Zipra1/Fuimini-V2/README.md

# This design is currently under development.
I do not recommend making this at the moment.
Case is currently not finished, but it should work.

nRF52833 based smol SlimeVR tracker

Design is optimized for manufacturability at medium scales & comfort
