Zipra1/Fuimini-V2/Accessories/Mini extension cable Desk stand.STEP

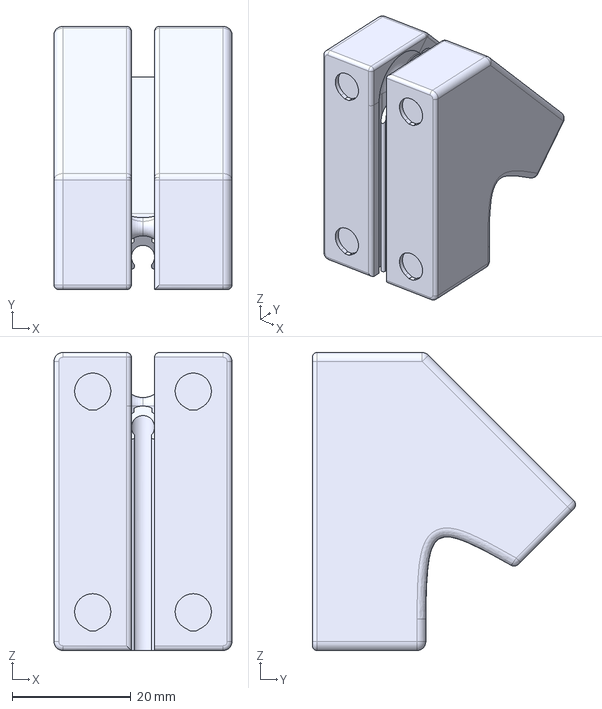
[picture p1: CAD file, 2025-12-10]
Accessories/Mini extension cable Desk stand.STEP
30.0 x 44.3 x 50.2 mm
