Zipra1/Fuimini-V2/Case models/Case.STEP

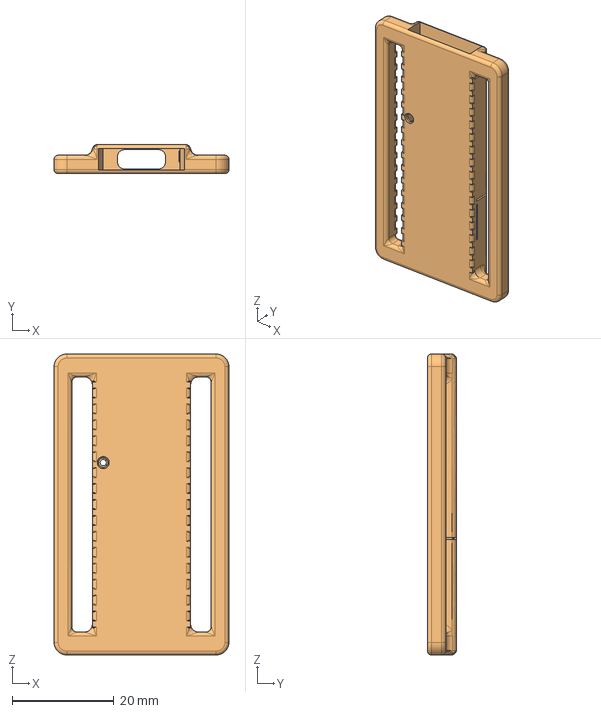
[picture p2: CAD file, 2025-12-30]
Case models/Case.STEP
34.3 x 5.71 x 59.0 mm
