Zipra1/Fuimini-V2/Case models/End cap.STEP

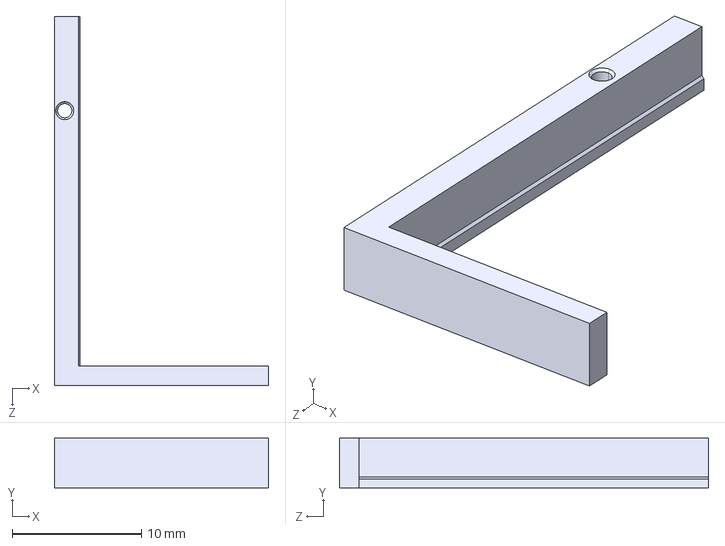
[picture p3: CAD file, 2025-12-30]
Case models/End cap.STEP
16.6 x 3.85 x 28.6 mm
