Zipra1/Fuimini-V2/(list of files, cad)

Other CAD files:
Tools/TC2030.STEP
