Zipra1/Fuimini-V2/KiCad/Fuimini-V2.kicad_pcb

## KiCad design KiCad/Fuimini-V2.kicad_pcb (2025-12-10)

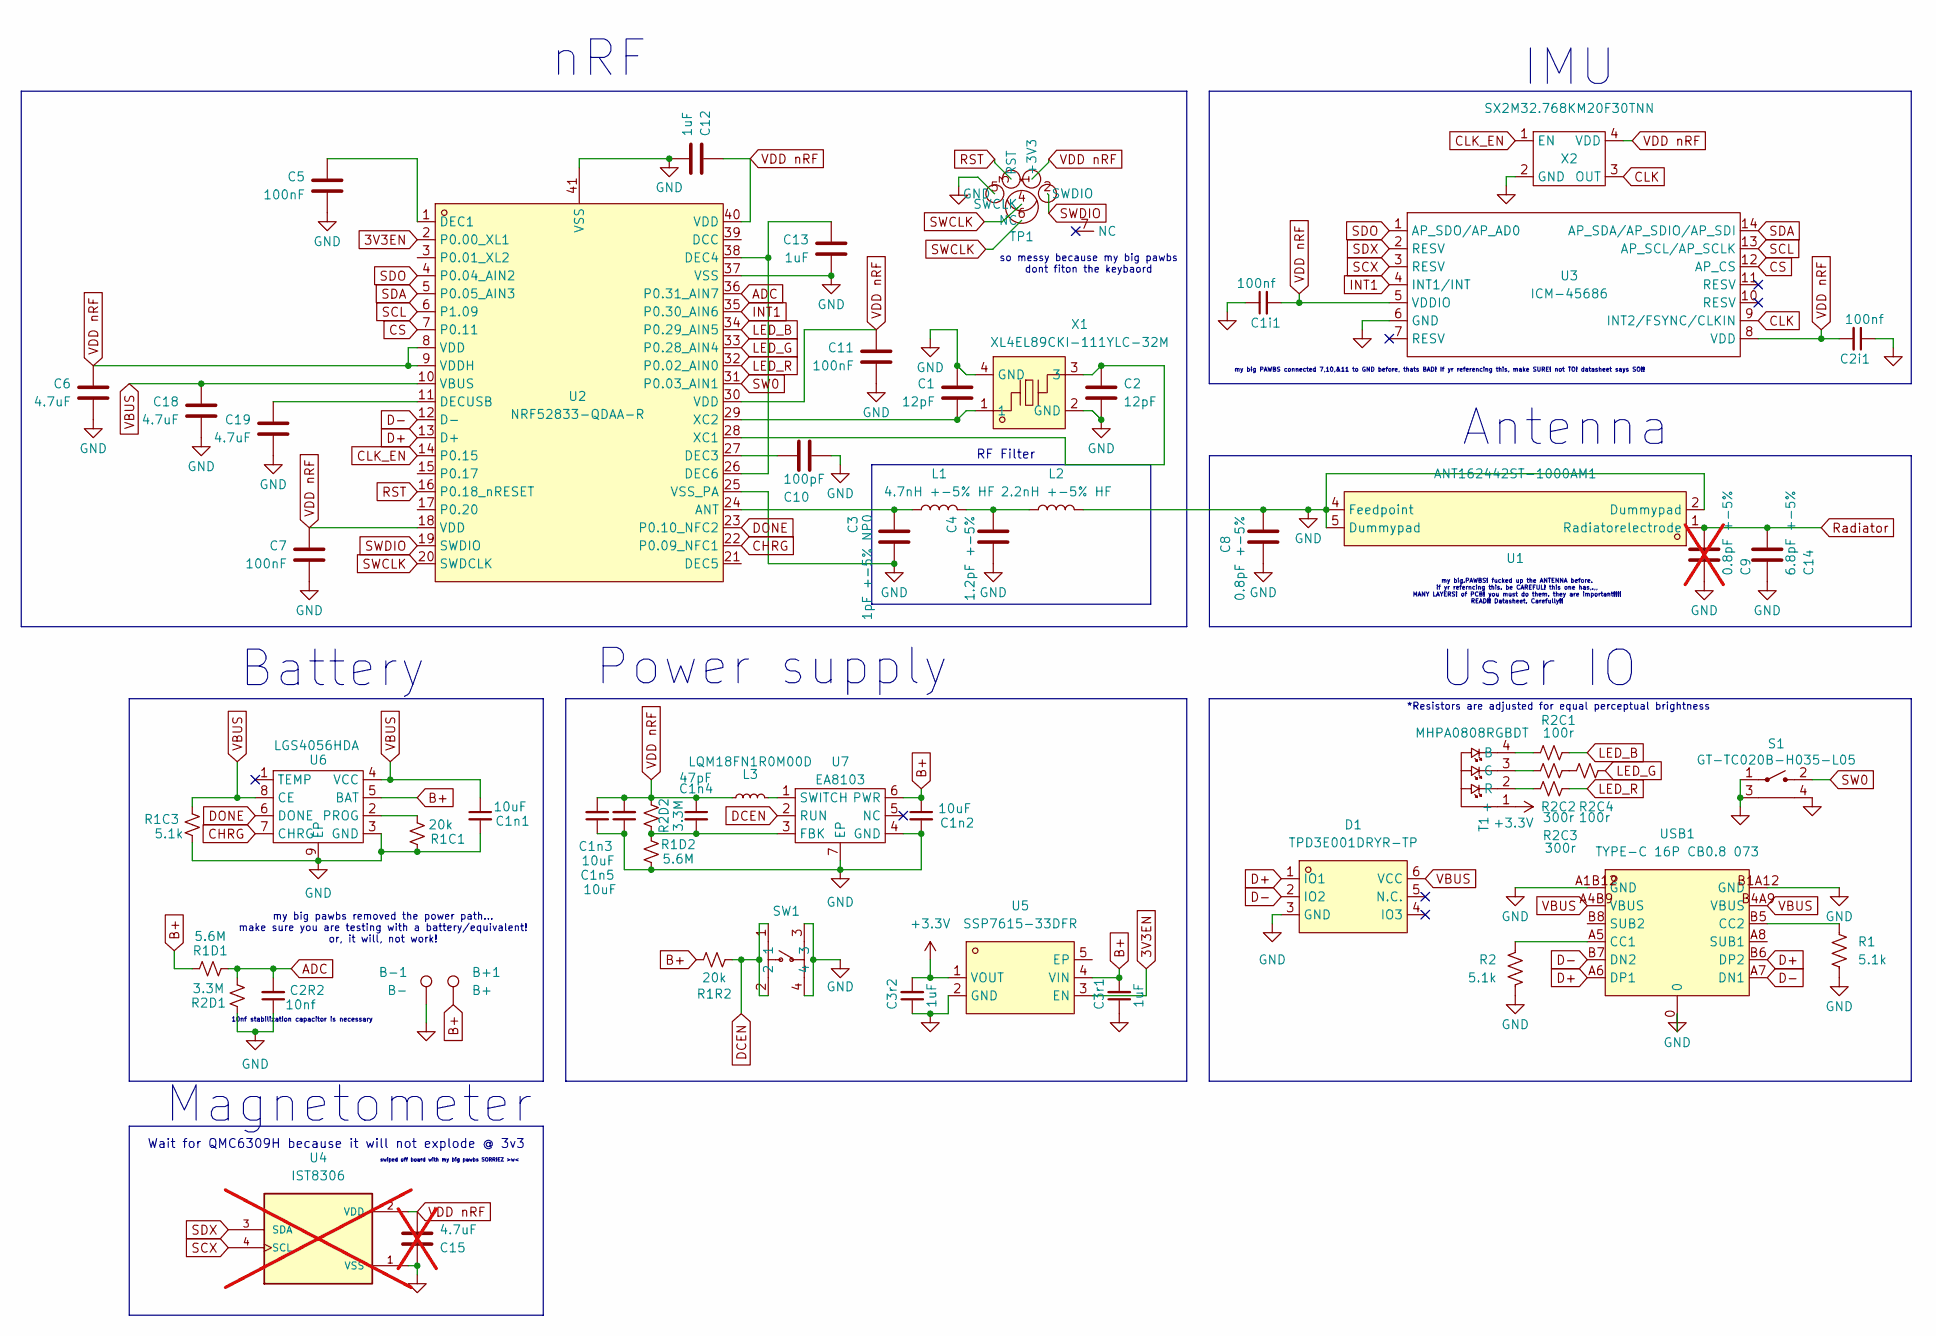
[picture p4: schematic Fuimini-V2.kicad_sch]

Parts:
B+1: B+; 2_3-1.5_2.5_1_1
B-1: B-; 2_3-1.5_2.5_1_1
C1, C2: 12pF; C_0201_JLC
C1i1, C2i1: 100nf; C_0201_JLC
C1n1, C1n2, C1n3, C1n5: 10uF; C_0402_JLC
C1n4: 47pF; C_0201_JLC
C2R2: 10nf; C_0201_JLC
C3: 1pF +-5% NP0; C_0201_JLC
C3r1, C3r2, C12, C13: 1uF; C_0201_JLC
C4: 1.2pF +-5%; C_0201_JLC
C5, C7, C11: 100nF; C_0201_JLC
C6, C18, C19: 4.7uF; C_0201_JLC
C8: 0.8pF +-5%; C_0201_JLC
C9: 0.8pF +-5%; C_0201_JLC; not fitted
C10: 100pF; C_0201_JLC
C14: 6.8pF +-5%; C_0201_JLC
C15: 4.7uF; C_0201_JLC; not fitted
D1: TPD3E001DRYR-TP; SON-6_L1.5-W1.0-P0.50-BL_SN74LVC1G19DRYR; LCSC Part C1973987
L1: 4.7nH +-5% HF; L_0201_0603Metric
L2: 2.2nH +-5% HF; L_0201_0603Metric
L3: LQM18FN1R0M00D; L0603
R1, R1C3, R2: 5.1k; R_0201_JLC
R1C1, R1R2: 20k; R_0201_JLC
R1D1, R1D2: 5.6M; R_0201_JLC
R2C1, R2C4: 100r; R_0201_JLC
R2C2, R2C3: 300r; R_0201_JLC
R2D1, R2D2: 3.3M; R_0201_JLC
S1: GT-TC020B-H035-L05; SW-SMD_GT-TC020B-H035-L05
SW1: 1TS026A-1100-0550-CT; SW-SMD_4P-L2.6-W1.6-P0.75-LS3.0; LCSC Part C913779
T1: MHPA0808RGBDT; LED-ARRAY-SMD_4P-L0.80-W0.80-BR
TP1: Paw-Connect_RevB_TC2030-IDC-NL_2x03_P1.27mm_Vertical
U1: ANT162442ST-1000AM1; ANT-SMD_6P-L1.6-W0.8-L; LCSC Part C5119334
U2: NRF52833-QDAA-R; QFN-40_L5.0-W5.0-P0.40-TL-EP3.6; LCSC Part C2895249
U3: ICM-45686; ICM-42688-P
U4: IST8306; PARTREV 1.4; not fitted
U5: SSP7615-33DFR; DFN-4_L1.0-W1.0-P0.65-BL-EP; LCSC Part C3011523
U6: LGS4056HDA; DFN-8_L2.0-W2.0-P0.50-TL-EP1.6
U7: EA8103; DFN-6_L1.5-W1.5-P0.50-BL-EP1.0
USB1: TYPE-C 16P CB0.8 073; USB-C-SMD_TYPE-C-16P-CB0.8-073; LCSC Part C2906289
X1: XL4EL89CKI-111YLC-32M; CRYSTAL-SMD_4P-L1.6-W1.2-BL; LCSC Part C18213028
X2: SX2M32.768KM20F30TNN; Crystal_SMD_2520-4Pin_2.5x2.0mm

Connections:
3V3EN: U2.2 (P0.00_XL1), U5.3 (EN)
+3.3V: C3r2.2, T1.1 (+), U5.1 (VOUT)
ADC: C2R2.2, R1D1.1, R2D1.2, U2.36 (P0.31_AIN7)
B+: B+1.1, C1n2.1, C3r1.2, R1D1.2, R1R2.1, U5.4 (VIN), U6.5 (BAT), U7.6 (PWR)
CHRG: U2.22 (P0.09_NFC1), U6.7 (CHRG)
CLK: U3.9 (INT2/FSYNC/CLKIN), X2.3 (OUT)
CLK_EN: U2.14 (P0.15), X2.1 (EN)
CS: U2.7 (P0.11), U3.12 (AP_CS)
D+: D1.1 (IO1), U2.13 (D+), USB1.A6 (DP1), USB1.B6 (DP2)
D-: D1.2 (IO2), U2.12 (D-), USB1.A7 (DN1), USB1.B7 (DN2)
DCEN: R1R2.2, SW1.1, SW1.2, U7.2 (RUN)
DONE: U2.23 (P0.10_NFC2), U6.6 (DONE)
GND: B-1.1, C1.1, C1i1.1, C1n1.2, C1n2.2, C1n3.1, C1n5.1, C2.2, C2R2.1, C2i1.1, C3.2, C3r1.1, C3r2.1, C4.2, C5.2, C6.2, C7.2, C8.1, C8.2, C9.1, C10.2, C11.2, C12.2, C13.2, C14.1, C15.1, C18.2, C19.2, D1.3 (GND), L2.2, R1.2, R1C1.2, R1C3.1, R1D2.1, R2.2, R2D1.1, S1.1, S1.3, S1.4, SW1.3, SW1.4, TP1.5 (GND), U1.2 (Dummypad), U1.4 (Feedpoint), U1.5 (Dummypad), U2.25 (VSS_PA), U2.37 (VSS), U2.41 (VSS), U3.6 (GND), U4.1 (VSS), U5.2 (GND), U6.3 (GND), U6.9 (EP), U7.4 (GND), U7.7 (EP), USB1.0, USB1.A1B12 (GND), USB1.B1A12 (GND), X1.2 (GND), X1.4 (GND), X2.2 (GND)
INT1: U2.35 (P0.30_AIN6), U3.4 (INT1/INT)
LED_B: R2C1.2, U2.34 (P0.29_AIN5)
LED_G: R2C4.2, U2.33 (P0.28_AIN4)
LED_R: R2C3.2, U2.32 (P0.02_AIN0)
unnamed: C4.1, L1.2, L2.1
unnamed: R2C2.2, R2C4.1
unnamed: R2C1.1, T1.4 (B)
unnamed: R2C2.1, T1.3 (G)
unnamed: R2C3.1, T1.2 (R)
unnamed: C3.1, L1.1, U2.24 (ANT)
unnamed: C5.1, U2.1 (DEC1)
unnamed: C10.1, U2.27 (DEC3)
unnamed: C13.1, U2.26 (DEC6), U2.38 (DEC4)
unnamed: C19.1, U2.11 (DECUSB)
unnamed: C2.1, U2.28 (XC1), X1.3
unnamed: C1.2, U2.29 (XC2), X1.1
unnamed: R1C1.1, U6.2 (PROG)
unnamed: C1n4.2, R1D2.2, R2D2.1, U7.3 (FBK)
unnamed: L3.2, U7.1 (SWITCH)
unnamed: R2.1, USB1.A5 (CC1)
unnamed: R1.1, USB1.B5 (CC2)
RST: TP1.3 (RST), U2.16 (P0.18_nRESET)
Radiator: C9.2, C14.2, U1.1 (Radiatorelectrode)
SCL: U2.6 (P1.09), U3.13 (AP_SCL/AP_SCLK)
SCX: U3.3 (RESV), U4.4 (SCL)
SDA: U2.5 (P0.05_AIN3), U3.14 (AP_SDA/AP_SDIO/AP_SDI)
SDO: U2.4 (P0.04_AIN2), U3.1 (AP_SDO/AP_AD0)
SDX: U3.2 (RESV), U4.3 (SDA)
SW0: S1.2, U2.31 (P0.03_AIN1)
SWCLK: TP1.4 (SWCLK), TP1.6 (NC), U2.20 (SWDCLK)
SWDIO: TP1.2 (SWDIO), U2.19 (SWDIO)
VBUS: C1n1.1, C18.1, D1.6 (VCC), R1C3.2, U2.10 (VBUS), U6.4 (VCC), U6.8 (CE), USB1.A4B9 (VBUS), USB1.B4A9 (VBUS)
VDD nRF: C1i1.2, C1n3.2, C1n4.1, C1n5.2, C2i1.2, C6.1, C7.1, C11.1, C12.1, C15.2, L3.1, R2D2.2, TP1.1 (+3V3), U2.8 (VDD), U2.9 (VDDH), U2.18 (VDD), U2.30 (VDD), U2.40 (VDD), U3.5 (VDDIO), U3.8 (VDD), U4.2 (VDD), X2.4 (VDD)

Notes on the sheet:
10nf stabilization capacitor is necessary
IMU
Magnetometer
Wait for QMC6309H because it will not explode @ 3v3
my big.PAWBS! fucked up the ANTENNA before. if yr referncing this. be CAREFUL! this one has,.,, MANY LAYERS! of PCB! you must do them. they are important!!!! READ!! Datasheet. Carefully!!
my big PAWBS connected 7,10,&11 to GND before, thats BAD! If yr referencing this, make SURE! not TO! datasheet says SO!!
nRF
RF Filter
Battery
User IO
swiped off board with my big pawbs SORRIEZ >w<
*Resistors are adjusted for equal perceptual brightness
Power supply
Antenna
so messy because my big pawbs dont fiton the keybaord
my big pawbs removed the power path... make sure you are testing with a battery/equivalent! or, it will, not work!

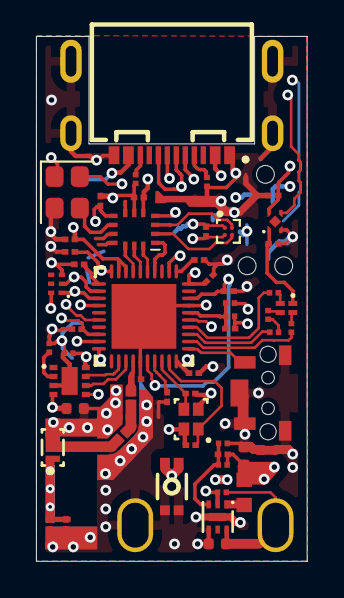
[picture p5: board Fuimini-V2.kicad_pcb from above]

Board: 4 copper layers, 15.0 x 29.2 mm, 60 parts (1 on the bottom side), 46 nets.
