Zipra1/Fuimini-V2/(commit log)

2025-06-07 Added KiCad files
    [MDTB50+icm.kicad_pcb, MDTB50+icm.kicad_sch, bom.csv, designators.csv, positions.csv]
2025-06-11 - Added DIY pcb (unfinished) - Edited README.md
    [MDTB50-DIY.kicad_pcb, MDTB50-DIY.kicad_sch]
2025-06-12 - Started redoing layout for DIY variant
    [MDTB50-DIY.kicad_pcb, MDTB50-DIY.kicad_sch]
2025-06-14 - DIY PCB fully routed. But it kinda sucks.
    [MDTB50+icm.kicad_pcb, MDTB50+icm.kicad_sch, MDTB50-DIY.kicad_pcb]
2025-06-17 - Changed PCB to 4 layer - Added QMC6309 magnetometer
    [MDTB50+icm.kicad_pcb, MDTB50+icm.kicad_sch, MDTB50-DIY.kicad_sch]
2025-06-19 - Finished back silkscreen for high volume version
    [MDTB50+icm.kicad_pcb, bom.csv, designators.csv, positions.csv]
2025-06-30 - Added external 1.8v regulator, external 3.3v regulator, QMC6309, logic level shifter for QMC6309, pushbutton power disconnect - Replaced USB C port for better one
    [MDTB50+icm.kicad_pcb, MDTB50+icm.kicad_sch]
2025-06-30 - Added ESD protection
    [MDTB50+icm.kicad_pcb, MDTB50+icm.kicad_sch, bom.csv, designators.csv, positions.csv]
2025-07-06 - No more non 90deg angles on components. Yay.
    [MDTB50+icm.kicad_pcb, MDTB50+icm.kicad_sch]
2025-08-05 - Added 0201 version with: DCDC, RGB LED, replaced charger IC, shortened by 2mm.
    [Case-Looped.STEP, Case.STEP, End cap.STEP, Holder.STEP, MDTB50+icm-0201 test.kicad_pcb, MDTB50+icm-0201 test.kicad_sch, MDTB50+icm.kicad_pcb, TC2030.STEP]
2025-10-03 - Changed MDBT50-P512K to bare nRF52833 chip. - Updated README
    [Fuimini-V2.kicad_pcb, Fuimini-V2.kicad_sch, MDTB50+icm-0201 test.kicad_pcb, MDTB50+icm-0201 test.kicad_sch, MDTB50+icm.kicad_pcb, MDTB50+icm.kicad_sch, MDTB50-DIY.kicad_pcb, MDTB50-DIY.kicad_sch]
2025-10-10 - Added test points for VBUS and VDD
    [Fuimini-V2.kicad_pcb]
2025-10-27 - Updated case models
    [Case-Looped.STEP, Case.STEP, End cap.STEP, Holder.STEP]
2025-11-16 - Moved IMU decoupling caps closer to IMU - Updated IMU footprint - Smoothed 2.4GHz RF trace - Disconnected 2.4GHz RF reference gnd from main gnd plane - Connected nRF pin 37 (gnd) to center ground p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
    [Fuimini-V2.kicad_pcb, Fuimini-V2.kicad_sch, bom.csv, designators.csv, positions.csv]
2025-12-10 - Updated PCB dont remember what (￣y▽,￣)╭ - Updated case design dont remember what (/▽＼)
    [Case.STEP, End cap.STEP, Fuimini-V2.kicad_pcb, Mini extension cable Desk stand.STEP]
2025-12-21 - Added device files for building own firmware
2025-12-30 - Improved fitment, added PCB strain relief, improved button clickiness, changed battery size (blehhh didn't really want to but need 2)
    [Case.STEP, End cap.STEP]
